Phoenix-flame/riscv-from-scratch/README.md

# Building a RISC-V CPU from Scratch (Simulation)

A step-by-step tutorial that builds a working **RV32I** single-cycle
processor in Verilog, simulated with **Icarus Verilog** and inspected with
**GTKWave**, on **Ubuntu 24.04**. Every module is delivered with a
self-checking testbench, so you always know whether a step works.

> _Developed collaboratively with Claude (Anthropic) — RTL, tests, software,
> and docs._

## What you will end up with

A processor that can execute real RISC-V machine code, including:

- Integer arithmetic / logic (`add`, `sub`, `and`, `or`, `xor`, `slt`, ...)
- Immediate instructions (`addi`, `andi`, `slli`, ...)
- Loads and stores (`lw`, `sw`)
- Branches and jumps (`beq`, `bne`, `blt`, `jal`, `jalr`)
- Upper-immediate instructions (`lui`, `auipc`)

It will run a small assembly program (computing a sum / a Fibonacci
sequence) and we will watch the registers change in the waveform viewer.

## Roadmap

| Step | Document | What we build | Status |
|---|---|---|---|
| 00 | `docs/00-overview.md` | The plan, the ISA, the architecture | written |
| 01 | `docs/01-environment-setup.md` | Install & verify the toolchain | written |
| 02 | `docs/02-verilog-crash-course.md` | Verilog refresher tied to real code | written |
| 03 | `docs/03-alu.md` | The ALU + testbench | **done & tested** |
| 04 | `docs/04-register-file.md` | The 32-register file | **done & tested** |
| 05 | `docs/05-memories.md` | Instruction & data memory | **done & tested** |
| 06 | `docs/06-immediate-and-control.md` | Immediate decode + control unit | **done & tested** |
| 07 | `docs/07-datapath.md` | Wiring the single-cycle datapath | **done & tested** |
| 08 | `docs/08-program-and-run.md` | Assemble a program & run it | **done & tested** |
| 09 | `docs/09-debugging-in-gtkwave.md` | Reading waveforms like a pro | **done & tested** |
| 10 | `docs/10-running-c.md` | Bonus: compile C and run it | **done & tested** |
| 11 | `docs/11-peripherals.md` | Bonus: UART, timer & a bus (SoC) | **done & tested** |
| 12 | `docs/12-initialized-data.md` | Bonus: string/array constants in RAM | **done & tested** |
| 13 | `docs/13-printf-without-libc.md` | Bonus: printf/snprintf via a mini-lib | **done & tested** |
| 14 | `docs/14-fpga-zynq.md` | Bonus: real UART + synthesizable top for Zynq | **done & tested** |
| 15 | `docs/15-interrupts.md` | Bonus: CSRs, traps & a timer interrupt | **done & tested** |
| 16 | `docs/16-mul-div.md` | Bonus: multiply/divide (RV32M) | **done & tested** |
| 17 | `docs/17-pipelining.md` | Bonus: a 5-stage pipelined core | **done & tested** |
| 18 | `docs/18-illegal-instruction-and-isa-faq.md` | FAQ: assembler vs hardware + illegal-instruction trap | **done & tested** |
| 19 | `docs/19-ecall-syscalls.md` | Bonus: `ecall` system calls + a syscall ABI | **done & tested** |
| 20 | `docs/20-pipelined-exceptions.md` | Bonus: precise exceptions/interrupts in the pipeline | **done & tested** |
| 21 | `docs/21-privilege-modes.md` | Bonus: machine/user privilege levels + protection | **done & tested** |
| 22 | `docs/22-mmu-virtual-memory.md` | Bonus: Sv32 MMU — virtual memory & page faults | **done & tested** |
| 23 | `docs/23-synthesizable-fpga.md` | Bonus: synthesizable BRAM SoC for Zynq-7010 (multi-cycle core) | **done & tested** |
| 24 | `docs/24-synthesizable-mmu.md` | Bonus: synthesizable Sv32 MMU (multi-cycle page-table walker, BRAM page tables) | **done & tested** |
| 25 | `docs/25-preemptive-multitasking.md` | Bonus: preemptive multitasking — timer-driven two-task scheduler | **done & tested** |
| 26 | `docs/26-atomic-extension.md` | Bonus: RV32A atomic extension (LR/SC + AMOs) for locks & synchronization | **done & tested** |
| 27 | `docs/27-freertos.md` | Bonus: running FreeRTOS (64-bit CLINT + RTOS SoC + port scaffolding) | **done & tested** |
| 28 | `docs/28-freertos-fpga.md` | Bonus: FreeRTOS on the synthesizable Zynq-7010 SoC (BRAM, real UART) | **done & tested (sim)** |
| 29 | `docs/29-debug-stub.md` | Bonus: debug stub — hardware debug module (halt/step/breakpoints) + gdb RSP server | **done & tested** |
| 30 | `docs/30-configurable-uart.md` | Bonus: configurable UART with RX path (runtime baud/data/parity/stop) on Zynq-7010 | **done & tested (sim)** |
| 31 | `docs/31-uart-interrupts.md` | Bonus: UART interrupts + receive-to-idle (machine external interrupt, IDLE-line detection) on Zynq-7010 | **done & tested (sim)** |
| 32 | `docs/32-branch-predictor.md` | Bonus: branch predictor (BTB + 2-bit saturating counters) on the pipelined core, with measured misprediction rate | **done & tested (sim)** |
| 33 | `docs/33-plic.md` | Bonus: PLIC interrupt controller — per-source priority / enable / threshold / claim-complete multiplexing several lines into one `MEIP` | **done & tested (sim)** |
| 34 | `docs/34-compressed.md` | Bonus: the C extension — 16-bit instructions, halfword-aligned PCs, word-straddling fetch; ~29% smaller code, verified against the rv32im build | **done & tested (sim)** |
| 35 | `docs/35-floating-point.md` | Bonus: the F extension — single-precision FPU (IEEE-754 round/guard/sticky, 5 rounding modes), the `f0`–`f31` float register file, `fcsr`; runs real `-march=rv32imf` gcc output, bit-exact vs host float32 (subnormals flushed) | **done & tested (sim)** |
| 36 | `docs/36-axi-master.md` | Bonus: an AXI4-Lite master to the Zynq PS — a stall-capable bus (`dmem_ready`), a 5-channel bus-to-AXI adapter, and a wait-state PS/DDR slave model; the core stalls on variable-latency accesses and reaches PS DDR + peripherals | **done & tested (sim)** |
| 37 | `docs/37-real-libc.md` | Bonus: a real C library (picolibc) — full `printf` + `malloc`/`free` via a tiny retarget (UART `putc`, heap symbols, `_exit`); byte-exact demo, and the FreeRTOS build swapped off the shims onto picolibc | **done & tested (sim)** |
| 38 | `docs/38-isolated-processes.md` | Bonus: memory-isolated processes — merge the Sv32 MMU (22/24) with the preemptive scheduler (25): a page table per task, `satp` reloaded on each context switch; two tasks share VA `0x1000` but land in different physical pages | **done & tested (sim)** |
| 39 | `docs/39-supervisor-delegation.md` | Bonus: supervisor mode + trap delegation — add S-mode (`cpu_mc_s`, `csr_s`) with `medeleg`/`mideleg`; a user `ecall`, an illegal instruction, and a software interrupt are delivered straight to an S-mode kernel, while an `ecall` from S still reaches M | **done & tested (sim)** |
| 40 | `docs/40-riscv-tests.md` | Bonus: the official **riscv-tests** suite — the reference per-instruction tests (rv32ui/um/ua/uc/uf) run against five cores through our own target environment; 272 test programs, and the two FPU bugs they found | **done & tested (sim)** |
| 41 | `docs/41-instruction-fetch-tlb.md` | Bonus: translated instruction fetch + TLBs — the PC becomes a virtual address (execute-only pages, instruction page faults), split 4-entry I/D TLBs make a hit cost zero cycles, and `sfence.vma` invalidates them; 2.36x fewer cycles than walking every access, and the whole rv32ui/um suite passes with translation on | **done & tested (sim)** |
| 42 | `docs/42-unified-pipeline.md` | Bonus: unify the cores — one 5-stage pipeline (`cpu_pipe_u`) with RV32IMA, M/U privilege, Sv32 fetch + data translation and I/D TLBs, and stall-capable ready/valid memory ports; precise page faults committed in EX, AMOs as two MEM requests, a shared walker borrowing the D-port; riscv-tests 58/58 in M and with Sv32 on in U | **done & tested (sim)** |
| 43 | `docs/43-caches.md` | Bonus: I-cache + write-back D-cache in front of a slow, burst-oriented (DDR-like) memory, on the unchanged unified pipeline; hits cost zero cycles, misses one line burst; 11× faster than no caches at latency 10 and 25× at 40 (CPI 2.0 / 2.7 vs 22.5 / 67.6), byte-exact vs the host compiler; D-cache vs a random reference model; MMU programs and riscv-tests through tiny caches | **done & tested (sim)** |
| 44 | `docs/44-smode-and-bpred-in-the-pipeline.md` | Bonus: supervisor mode (`medeleg`/`mideleg`, `sret`, `stval`, SUM/MXR, translation in S) and the BTB + 2-bit branch predictor folded into the unified pipeline; an S-mode kernel running translated serves its user's page faults (demand paging, fetch faults), the Step 39 demo runs unchanged, and the predictor reproduces Step 32's 3544 → 879 mispredictions | **done & tested (sim)** |
| 45 | `docs/45-menuconfig-openzynq.md` | Bonus: `make menuconfig` (Kconfig) generates a RISC-V project for OpenZynq / Mitra-7010 — pipeline or multi-cycle core, every feature a parameter that removes hardware, standalone or PS-attached (AXI loader + console), with a per-configuration self-test and testbench; 9 presets pass in simulation and synthesize with Yosys 0.68 | **done & tested (sim + synth)** |
| 46 | `docs/46-bitmanip.md` | Bonus: the bit-manipulation extensions Zba/Zbb/Zbc/Zbs in the unified pipeline — a combinational unit beside the ALU, strict OP/OP-IMM decode so an unconfigured extension traps, each group a parameter and a menuconfig option; the official `rv32uzb*` riscv-tests (32) pass on all four pipeline configurations (90/90) | **done & tested (sim + synth)** |
| 47 | `docs/47-vector.md` | Bonus: the RISC-V vector extension (Zve32x subset, VLEN 64/128/256) — an element-serial unit holding EX, VRF in LUT RAM, vector memory translated by the D-TLB/walker, precise mid-vector page faults with `vstart` resume, fault-only-first, `mstatus.VS`; random differential testing against a Python RVV model (thousands of programs, with and without caches), an Sv32 fault test, a menuconfig option, and a 1.3–2.4× scalar-vs-vector benchmark | **done & tested (sim + synth)** |
| 48 | `docs/48-benchmarks.md` | Bonus: benchmarks — Dhrystone and CoreMark on the unified pipeline, timed by new `cycle`/`instret` counters (Zicntr) and stall-event counters (Zihpm) whose categories add up to every cycle exactly; **1.37 DMIPS/MHz** and **2.88 CoreMark/MHz** (3.31 with `-O3` + Zb) on ideal memory, with the predictor, compiler and cache effects broken down cycle by cycle; Verilator runs the matrix in minutes, cycle-identical to Icarus | **done & tested (sim + synth)** |
| 49 | `docs/49-bootloader-device-tree.md` | Bonus: boot ROM + device tree + SBI — a `virt`-style platform (`soc_boot`: one memory for fetch and data, an ns16550a UART, the standard CLINT, a test device) whose ROM loads CRC-checked images over the serial port, checks every segment before writing a byte, fixes up the DT (probed RAM size, `bootargs`) and stays resident as an SBI v2.0 (BASE/TIME/DBCN/SRST); `make boot` rejects two bad images, then runs an S-mode program that knows the machine only from its DT, an M-mode one that reboots through `syscon-reboot`, and Step 37's picolibc demo unchanged; `time` CSR and a refetching `FENCE.I` in `cpu_pipe_u` (riscv-tests `fence_i` now passes) | **done & tested (sim)** |
| 50 | `docs/50-plic-access-faults-svade.md` | Bonus: what a kernel expects underneath it — a standard-layout PLIC with M and S contexts (the UART's interrupt reaches S-mode as SEIP), precise access faults from a PMA check of every fetch, load/store/AMO and page-table read against the memory map (causes 1/5/7 instead of reads of 0), and Svade A/D-bit page faults in the walker; `kdemo` handles all three the way Linux does, inside `make boot` | **done & tested (sim)** |
| 51 | `docs/51-boot-memory-system.md` | Bonus: memory for the boot platform — `soc_boot` with I/D caches over one memory (`line_arb`), either block RAM (the board build, `fpga_top_boot`: 144 KiB in the PL) or 64 MiB of DDR through a new AXI4 burst master; a coherent `FENCE.I` (the core waits while the D-cache is written back and the I-cache invalidated); `make boot` passes the same transcript on all three memory systems, and riscv-tests' `fence_i` passes through unified caches (`pipe_c_uni`, 91/91) | **done & tested (sim + synth)** |
| 52 | `docs/52-misaligned-traps.md` | Bonus: misaligned accesses trap — `cpu_pipe_u` raised none and did them silently wrong; now a misaligned load / store / AMO raises cause 4 / 6 and a jump to an unaligned target cause 0, with the address in `mtval`, checked before translation; the ROM delegates them to S, and `kdemo` emulates them with a kernel-style trap entry (and a misaligned Linux user program now works, with the misaligned AMO getting SIGBUS) | **done & tested (sim)** |
| 53 | `docs/53-linux.md` | Bonus: Linux from source — `make linux` fetches pinned, hash-checked Linux 6.18, busybox 1.36.1 and musl 1.2.5, builds an RV32IMA soft-float userland and a tinyconfig-based kernel (`sw/linux/*.config`), sends it to the boot ROM over the simulated UART of `soc_boot` with 64 MiB of DDR, types seven commands at its shell and checks the transcript (17 checks, clean power-off); `make linux-fast` preloads the kernel instead | **done & tested (sim)** |
| 54 | `docs/54-linux-on-the-board.md` | Bonus: the DDR path to the Mitra-7010 — `axi4_line_master` and the DDR model at 64 bits (4-beat AXI3 bursts, the shape of `S_AXI_HP0`); `fpga_top_linux`: `soc_boot` on OpenZynq's `ps7_gp0` with HP0, its 64 MiB at PS DDR `0x1000_0000`, held in reset until the PS program (DDR init, a DDR check) says *run* over GP0; `make linux-oz OZ=...` writes the OpenZynq project and simulates its top on OpenZynq's own `ps7_gp0`; `make linux-board` boots Linux on the board's exact configuration; `rvboot send` loads a board over a USB-serial adapter | **done & tested (sim); not yet placed, routed or run on a board** |
| 55 | `docs/55-u-boot.md` | Bonus: U-Boot in front of Linux — `make uboot` fetches pinned U-Boot v2024.10 and builds it for `soc_boot` (S-mode on the ROM's SBI and device tree, no C/F/D/EFI), a simulator and a board build, plus one image holding U-Boot and the kernel; `make linux-uboot` boots it: U-Boot autoboots, `booti` moves the kernel to `0x8040_0000`, Linux reaches its shell (20 checks) | **done & tested (sim)** |
| 56 | `docs/56-boot-from-flash.md` | Bonus: booting from flash with no PC — the ROM boots an RVBI image it finds in RAM at `0x8300_0000` through the same checks (a corrupt one, or a key within a second, gives the serial prompt; `make boot-mem`); the PS program doubles as the FSBL of a `BOOT.BIN`: in QSPI boot mode it programs the PL through PCAP and copies U-Boot + Linux from flash into the RISC-V's DDR; `rvboot flash` writes `BOOT.BIN` to the QSPI flash through it, CRC- and format-checked before any erase; `make linux-frommem` boots U-Boot + Linux from memory on the board configuration; `make ps-test` runs the parser and flash writer against a controller + flash model | **done & tested (sim; FSBL against a model); not yet run on a board** |

**On the board:** [`docs/mitra-board-guide.md`](docs/mitra-board-guide.md) is the step-by-step guide to running U-Boot and Linux on the Mitra-7010: hardware, builds, the OpenZynq bitstream, wiring, bring-up checks, troubleshooting, and what "flashing" can and cannot mean for this design today.

## Directory layout

```
riscv-cpu-tutorial/
├── README.md          <- this file
├── docs/              <- the tutorial, one markdown file per step
├── rtl/               <- synthesizable hardware (the CPU itself)
├── tb/                <- testbenches (simulation-only checking code)
├── sw/                <- assembly programs the CPU will run
├── tools/             <- helper tools (rvsim: run a program & dump state)
└── build/             <- compiled simulations + .vcd waveforms (generated)
```

## Quick start (after reading step 01)

```bash
# Compile and run the ALU test
iverilog -g2012 -Wall -o build/alu_tb.vvp rtl/alu.v tb/alu_tb.v
vvp build/alu_tb.vvp

# Open its waveform
gtkwave build/alu_tb.vcd
```

Start with `docs/00-overview.md`.

## Run a program & inspect the CPU (`rvsim`)

`tools/rvsim` is a small command-line front-end that loads a program onto
the CPU, runs it, and prints the final register file, PC and memory —
without hand-writing a testbench. It accepts a raw **`.bin`**, a
**`.hex`** (`$readmemh` word image), or an **`.elf`** (converted for you).

```bash
# Run a raw binary on the single-cycle core and show the registers
tools/rvsim path/to/prog.bin

# Run the peripheral demo on the SoC (real UART output + self-halt)
tools/rvsim sw/socdemo.hex --core soc --data sw/socdemo_data.hex

# Compiled ELF, trace each cycle, and dump 16 data words from address 0
tools/rvsim prog.elf --trace --cycles 200 --mem 0:16

# Same thing through make
make run BIN=path/to/prog.bin
make run BIN=sw/socdemo.hex CORE=soc DATA=sw/socdemo_data.hex
```

Sample output:

```
──────────────────────────────────────────────────────────────
RISC-V CPU state   (cpu: single-cycle core (rtl/cpu.v))
──────────────────────────────────────────────────────────────
  program : prog.bin
  cycles  : 13     halt: PC stalled (spin loop)
  pc      : 0x00000024     instr: 0x0000006f

  x0  zero 0x00000000   x8    s0 0x00000000   x16   a6 0x00000000   x24   s8 0x00000000
  x1    ra 0x00000005   x9    s1 0x00000000   x17   a7 0x00000000   x25   s9 0x00000000
  ...
```

Useful flags (`tools/rvsim --help` for all):

| Flag | Meaning |
|---|---|
| `--core {cpu,soc}` | single-cycle core (default) or full SoC with UART/timer/halt |
| `--cycles N` | max cycles before stopping (default 200000) |
| `--trace` | print `pc`/`instr` for every retired cycle |
| `--mem START:COUNT` | hex-dump `COUNT` data words from byte `START` (e.g. `0x40:8`) |
| `--data FILE` | preload data memory (auto-derived from an `.elf`) |
| `--dec` | also show registers as signed decimals |
| `--vcd` | also write a GTKWave waveform under `build/` |

The run stops on its own when the program spins (`j .`), runs off the end,
halts via the SoC's syscon device, or hits the cycle cap. Both cores have a
4 KB (1024-instruction) instruction memory, so this is aimed at the small
bare-metal programs in `sw/`.

### Interactive mode — a stepping debugger

Run `rvsim` with **no program** (or pass `-i`) and it drops into an
interactive shell instead of a one-shot dump — a little gdb-for-the-tutorial
where you step the CPU cycle by cycle and watch the registers change, with
inline disassembly, breakpoints and a full trace.

```bash
tools/rvsim                    # empty shell — then: load sw/sum.hex
tools/rvsim -i sw/sum.elf      # load a program and start stepping
make sim BIN=sw/sum.hex        # same thing through make
```

```
rvsim 6/49 ❯ step
● cycle 7/49  pc 0x0000000c  00315863  bge sp,gp,0x1c
  Δ x2 sp  0x00000002 → 0x00000003  (3)

rvsim 7/49 ❯ break 0x1c        # stop when PC reaches the store
rvsim 7/49 ❯ continue
● cycle 44/49  pc 0x0000001c  00102023  sw ra,0(zero)
  Δ x1 ra  0x00000003 → 0x00000037  (55)
```

It works by re-running the deterministic simulation to a cycle *cursor*, so
`step`, `back`, `goto` and `continue` all just move that cursor — no waveform
digging required. Type `help` for the full command list; the highlights:

| Command | What it does |
|---|---|
| `load FILE` | load a `.bin`/`.hex`/`.elf` and reset to cycle 0 |
| `step [N]` / `back [N]` | advance / rewind N cycles, showing what changed |
| `continue` | run to the next breakpoint (or the natural halt) |
| `goto CYCLE` / `reset` | jump the cursor to an absolute cycle / to 0 |
| `break PC` / `breaks` / `delete` | set / list / remove PC breakpoints |
| `regs` / `mem START:COUNT` / `trace [N]` | inspect registers / RAM / history |
| `core {cpu,soc}` / `cycles N` / `dec` | switch core / cap / decimal display |
| `vcd` | write a GTKWave waveform of the current program |

Inline disassembly and breakpoints need a `riscv64-unknown-elf-objdump` on
`PATH`; without it the shell still steps and shows the raw instruction word.

## Run the official riscv-tests suite (`rvtests`)

`tools/rvtests` runs [riscv-tests](https://github.com/riscv-software-src/riscv-tests),
the reference per-instruction suite, against the cores. It fetches the suite
into `third_party/` on first use (pinned commit, gitignored), builds each test
against the target environment in `tests/riscv-tests/env/`, and runs them all on
a compiled-once harness.

```bash
make riscv-tests                       # default core (cpu_mc)
make riscv-tests CORE=all              # every core, plus a summary matrix
make riscv-tests CORE=pipe ARGS="add sra"
tools/rvtests --trace rv32ui-add       # one test, cycle by cycle
tools/rvtests --list                   # what would run
```

```
──────────────────────────────────────────────────────────────
  riscv-tests   core: pipe  — 5-stage pipeline RV32IM + Zicsr
                built: -march=rv32im_zicsr_zifencei -mabi=ilp32
──────────────────────────────────────────────────────────────
  rv32ui-add               pass  537 cycles
  rv32ui-fence_i           gap   unexpected trap in sub-test 0
  ...
──────────────────────────────────────────────────────────────
  rv32ui 41/41   rv32um 8/8      total 49/49   ALL PASS
```

| Core | RTL | Suites | Result |
|---|---|---|---|
| `sc` | `cpu_core.v` — single-cycle RV32IMA | ui, um, ua | 59/59 |
| `mc` | `cpu_mc.v` — multi-cycle RV32IM | ui, um | 48/48 |
| `mc_c` | `cpu_mc_c.v` — multi-cycle RV32IMC | ui, um, uc | 49/49 |
| `mc_f` | `cpu_mc_f.v` — multi-cycle RV32IMF | ui, um, uf | 58/58 |
| `pipe` | `cpu_pipe_trap.v` — 5-stage pipeline | ui, um | 49/49 |
| `mc_tlb` | `cpu_mc_tlb.v` — multi-cycle RV32IM, run with Sv32 **on** (identity map, U-mode) through the I/D TLBs | ui, um | 48/48 |
| `pipe_u` | `cpu_pipe_u.v` — unified pipeline RV32IMA, M/S/U, MMU, branch predictor (body in M) | ui, um, ua, uzba, uzbb, uzbc, uzbs | 90/90 |
| `pipe_u_vm` | `cpu_pipe_u.v` — same, body in U with Sv32 **on** | ui, um, ua, uzb* | 90/90 |
| `pipe_u_uni` | `cpu_pipe_u.v` with ONE memory for fetch and data, as `soc_boot` (Step 49) — so `fence_i` passes | ui, um, ua, uzb* | 91/91 |
| `pipe_c_uni` | the same behind I/D caches over ONE slow memory (Step 51): `fence_i` needs the D-cache cleaned and the I-cache invalidated | ui, um, ua, uzb* | 91/91 |
| `pipe_c` | `cpu_pipe_u.v` behind 512 B I$/D$ on slow memory (latency 5) | ui, um, ua, uzb* | 90/90 |
| `pipe_c_vm` | same, body in U with Sv32 **on** (PTEs read through the D$) | ui, um, ua, uzb* | 90/90 |

Tests that cannot pass on this hardware (`fence_i` on the Harvard cores, `ma_data`
on the word-RAM cores, `fmadd`) are still run and reported as documented gaps rather than
skipped, so a gap that closes shows up as readily as one that opens. See
`docs/40-riscv-tests.md` for what the suite found.

## Acknowledgements

This project was developed collaboratively with **Claude**, Anthropic's AI
assistant. Claude helped design and write the RTL, the self-checking
testbenches, the bare-metal software and toolchain flow, and all of the
step-by-step tutorial documents — with each module built bottom-up and verified
in simulation along the way.

## Future directions (roadmap beyond Step 27)

A menu of where this project can go next, grouped by goal. Rough difficulty:
🟢 weekend–week · 🟡 multi-week · 🔴 multi-month.

### Onto real silicon
- ✅ **Run FreeRTOS on the Zynq-7010** — synthesizable BRAM SoC (`soc_rtos_fpga` + `fpga_top_rtos`), real UART, verified in sim (Step 28). Vivado bitstream is the remaining manual step.
- ✅ **AXI4-Lite master to the PS** — a stall-capable core (`cpu_mc_stall` waits on `dmem_ready`), a 5-channel bus-to-AXI4-Lite adapter, and a `soc_axi` that windows `0x4000_0000` out to the PS (Step 36). Verified against a wait-state AXI slave modelling PS DDR + a peripheral; reads/writes round-trip correctly through the stalls. Full AXI4 bursts (AXI-HP for DDR bandwidth) wait on a cache or DMA engine to generate them.
- 🔴 **Tape-out flow** — push RTL through OpenLane + SkyWater sky130 to a GDSII layout.

### Deeper OS
- ✅ **Memory-isolated processes** — per-task page tables with `satp` reloaded on every context switch (Step 38). Two preempted user tasks share the same virtual addresses (private page at VA `0x1000`, stack at `0x2000`) yet map to different physical pages, so neither can touch the other's memory; the MMU enforces it, the kernel just hands each task its own address space. Built on the unmodified synthesizable MMU SoC. A TLB (and the `sfence.vma` it would require) is the natural next step.
- ✅ **Supervisor mode + `medeleg`/`mideleg`** — a third privilege level (S) with per-cause trap delegation (Step 39). Two bit-masks route traps taken below machine mode: a delegated cause vectors straight to the S-mode handler at `stvec`, updates the supervisor trap CSRs, and enters S — machine mode never runs. The demo delegates a user `ecall`, an illegal instruction, and a supervisor software interrupt to an S-mode kernel, while a non-delegated `ecall` from S still reaches M. `sstatus`/`sie`/`sip` are masked views of the machine registers; built on a fresh `cpu_mc_s`/`csr_s` so the rest of the regression is untouched. Step 44 brings S-mode to the unified pipeline, where an S-mode kernel running translated serves its user's page faults (demand paging with `stval`, SUM, fetch faults) without M ever running.
- ✅ **Instruction-fetch translation + TLB** — a new core, `cpu_mc_tlb` (Step 41), translates the PC as well as data: user code runs at a virtual address, execute-only pages work, and a leaf without `X` raises an instruction page fault (cause 12). Split fully-associative I/D TLBs (`tlb.v`, 4 entries each) cache finished walks, so a hit costs no cycles, and `sfence.vma` (all entries, or by address) invalidates them. The demo shows a stale translation surviving a PTE change until the fence; against a walk-every-access build it takes 2.36x fewer cycles, and rv32ui/um pass 48/48 with every fetch and access translated. ASID-tagged entries (so a `satp` switch needs no flush) are the natural next step.
- 🔴 **Port xv6-riscv, then Linux** — xv6 is the realistic next OS. Linux needs S-mode, MMU + TLBs, atomics (Steps 39–44), a device tree, the SBI and the boot protocol (Step 49), a PLIC on SEIP, access faults and A/D-bit handling (Step 50), and megabytes of RAM behind caches with a coherent `FENCE.I` (Step 51: 64 MiB of DDR over AXI4 in simulation), and misaligned accesses that trap so the kernel can emulate them (Step 52). Linux now boots to a busybox shell in simulation: `make linux` (Step 53) builds mainline 6.18, busybox and musl from source and checks the shell. For the board, Step 54 wires that RAM to the PS's DDR through `S_AXI_HP0` and generates the OpenZynq project (`make linux-oz`); it is simulated, not yet placed, routed or run on hardware. Step 56 lets the board boot U-Boot and Linux from its QSPI flash with no PC (`BOOT.BIN`, the PS program as FSBL). Still missing: xv6, and a bring-up of Steps 54–56 on a real board.

### Make it fast (microarchitecture)
- ✅ **Branch predictor** — BTB + 2-bit saturating counters on the pipelined core (Step 32): 3544 flushes → 879 mispredictions on the demo, ~1.3x fewer cycles. Return-address stack is the natural follow-up.
- ✅ **I-cache / D-cache** — direct-mapped I-cache and write-back, write-allocate D-cache (Step 43) on the unified pipeline's ready/valid ports, in front of `mem_slow`, a DDR-like memory (first-word latency, then one word per cycle). Hits cost nothing; a miss is one line burst. On a mixed benchmark the caches give 4.9× / 11× / 25× over no caches at latency 1 / 10 / 40 (CPI 1.8 / 2.0 / 2.7 vs ideal 1.55), and the remaining cost is exactly misses × latency. Verified against a random reference model, byte-exact vs the host compiler, and with the MMU programs and riscv-tests through 256–512-byte caches. A single-port DDR arbiter, AXI4 bursts and a registered (BRAM-sized) lookup are the next steps.
- ✅ **Unify the cores** — `cpu_pipe_u` (Step 42): the 5-stage pipeline now has atomics (RV32A), user mode, and the Sv32 MMU with translated fetch and I/D TLBs, behind stall-capable ready/valid memory ports. Data translation sits in EX so page faults are precise for free; fetch faults ride down the pipe as tokens; AMOs are two MEM requests; one walker borrows the D-port. The Step 41 TLB demo runs unchanged (1339 vs 2050 cycles on `cpu_mc_tlb`), Step 38's isolated processes run with fetch translated (and fail without the `sfence.vma`), and riscv-tests pass 58/58 both in M and with Sv32 on in U. Step 44 then folds in the two that Step 42 left out: supervisor mode with delegation (Step 39) and the branch predictor (Step 32), so the fast core now has every privilege, memory-system and prediction feature in the project; the C and F extensions (Steps 34/35) and the debug module (Step 29) remain on their own cores.
- 🔴 **Superscalar / out-of-order** — Tomasulo, register renaming, reorder buffer.

### Broaden the ISA
- ✅ **C (compressed)** — RV32IMC core (`cpu_mc_c` + `rvc_expand`, Step 34): 1:1 expansion to base instructions, halfword PCs, straddling fetches resolved in one extra cycle. Same program, 424 → 302 code bytes. A fetch buffer is the natural follow-up.
- ✅ **F (single-precision floating point)** — single-precision FPU, the `f0`–`f31` float register file, and `fcsr` (Step 35): runs real `-march=rv32imf` gcc output and matches host float32 bit-for-bit across the normal range (367-point unit test + compiled-program integration test). Subnormals are flushed to zero. Double precision (D) and the fused multiply-add family are the natural follow-ups.
- ✅ **Zb (bit-manip)** — Zba/Zbb/Zbc/Zbs in the unified pipeline (Step 46): one combinational unit beside the ALU, strict OP/OP-IMM decode so a group that is configured out traps, each group a menuconfig option; the official `rv32uzb*` riscv-tests pass on all four pipeline configurations.
- ✅ **V (vector)** — Zve32x subset on the unified pipeline (Step 47): `vsetvl*`, unit/strided/indexed/fault-only-first/whole-register memory ops translated by the MMU, integer arithmetic, multiply-add, compares, masks, reductions, slides; precise mid-vector page faults resume at `vstart`; `mstatus.VS`. Element-serial — the next performance steps are lanes, word-wide unit-stride access and chaining.
- 🔴 **RV64** — widen to 64-bit; required for Linux.

### Rigorous correctness
- ✅ **riscv-tests** — the official per-instruction suite, running against five cores (Step 40). riscv-tests ships the tests but deliberately not the environment, so `tests/riscv-tests/env/` supplies ours: a Harvard link script and a `tohost` that is the SYSCON halt register, so the store reporting the result is the store that stops the machine. 272 test programs: `sc` 59/59, `mc` 48/48, `mc_c` 49/49 (whole base suite rebuilt as RVC), `mc_f` 58/58, `pipe` 49/49. It found and fixed two real FPU bugs — `fmin.s(-0.0,+0.0)` returned `+0.0`, and `fcvt.wu.s` had its invalid flag on the wrong side of the range check. Three tests are reported as documented gaps rather than skipped: `fence_i` (the instruction ROM is write-once), `ma_data` on the word-RAM cores (misaligned accesses are silently wrong), `fmadd` (no fused multiply-add). `rv32mi`/`rv32si` are the natural next step and need the machine CSR set built out first.
- 🟡 **Differential testing vs Spike** — same program on core + reference sim, compare state each step.
- 🟡 **Benchmark** — Dhrystone / CoreMark, report DMIPS/MHz and CoreMark/MHz.
- 🔴 **Formal verification** — riscv-formal + SymbiYosys.

### Multi-core / SMP
- 🔴 **Two harts** — duplicate the core with distinct `mhartid`, shared memory + arbiter, cross-core LR/SC (where `aq`/`rl` finally matter); then SMP FreeRTOS / Linux.

### Tooling & ecosystem
- ✅ **Debug stub** — hardware debug module (halt/step/4 HW breakpoints/reg+mem access) + gdb RSP server (Step 29); transport bridge to live gdb is the remaining glue.
- ✅ **Real libc** — picolibc with full `printf` and `malloc`/`free` (Step 37). The platform contract is three hooks: a UART `putc` for `stdout`, `__heap_start`/`__heap_end` for the allocator, and `_exit`. A byte-exact demo (`make libc`) checks formatting + heap + `string.h`, and the FreeRTOS build now links picolibc with the header shims and the `firmware.c` mini-printf retired (verified running through real `printf`).
- ✅ **Bootloader + device tree** — boot ROM + DT + SBI on `soc_boot` (Step 49): images arrive over a 16550 UART with header and data CRCs, every segment is range-checked before the first write, the ROM fixes up the DTB in place (probed RAM size, `/chosen/bootargs`; `dtc` re-reads the result) and enters the payload with the RISC-V boot protocol (`a0` = hart, `a1` = DTB, S-mode), leaving an SBI v2.0 behind that forwards the machine timer as STIP. Three programs run back to back over two resets; the RX FIFO never holds more than one byte. Next: block-RAM memories for the board, a PLIC wired to SEIP, and A/D-bit handling in the walker.

### Peripherals & interrupts
- ✅ **UART interrupts + receive-to-idle** — machine external interrupt (cause 11) wired to a configurable UART, with STM32-style IDLE-line detection to receive whole variable-length messages (Step 31).
- ✅ **Interrupt controller (PLIC)** — per-source priority / enable / threshold / claim-complete multiplexing several lines into one `MEIP` (Step 33). Surfaced and fixed a read-side-effect bus bug via a new `dmem_re` read strobe. Step 50 adds the standard `sifive,plic-1.0.0` layout with an S-mode context (`plic_sifive`), so a supervisor kernel takes the UART's interrupt as SEIP.
- 🟡 **Richer peripherals** — SPI/I2C masters, GPIO with edge interrupts, a PWM/timer-capture block — each behind the same MMIO + IRQ pattern.

### For fun / applications
- 🟢🟡 **Doom (bare-metal RV32)**, a tiny TCP stack (lwIP), a shell, or framebuffer graphics — proof it's a *computer*.
