Phoenix-flame/riscv-from-scratch/docs/img/menuconfig/02-project.png

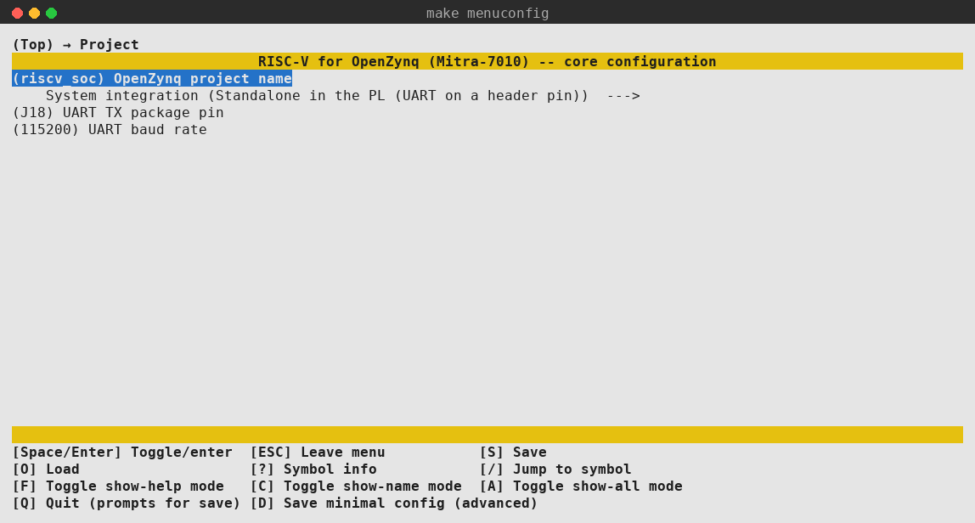
docs/img/menuconfig/02-project.png
