Phoenix-flame/riscv-from-scratch/docs/img/menuconfig/04-isa-pipe.png

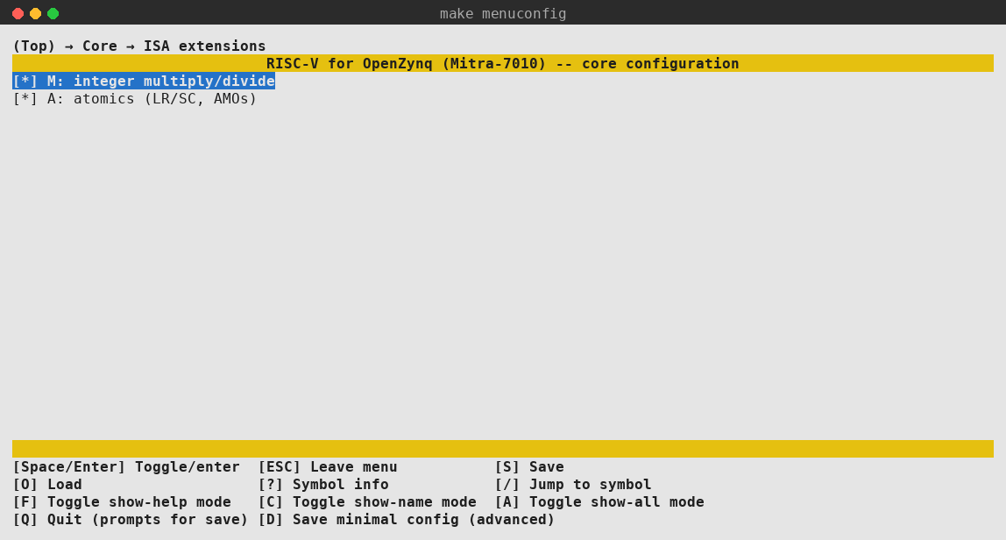
docs/img/menuconfig/04-isa-pipe.png
