Phoenix-flame/riscv-from-scratch/docs/img/menuconfig/14-edit-int.png

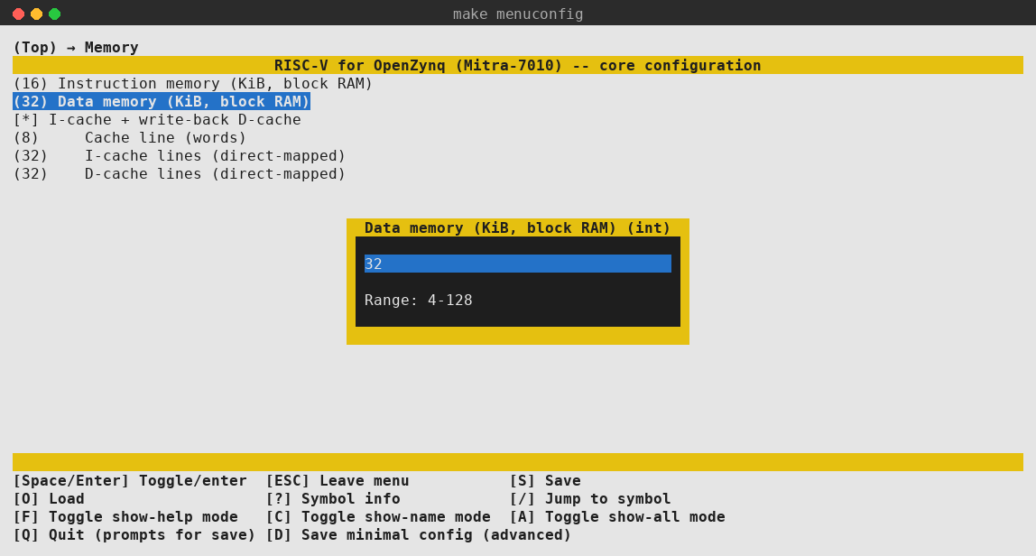
docs/img/menuconfig/14-edit-int.png
