Phoenix-flame/riscv-from-scratch/docs/img/menuconfig/16-names.png

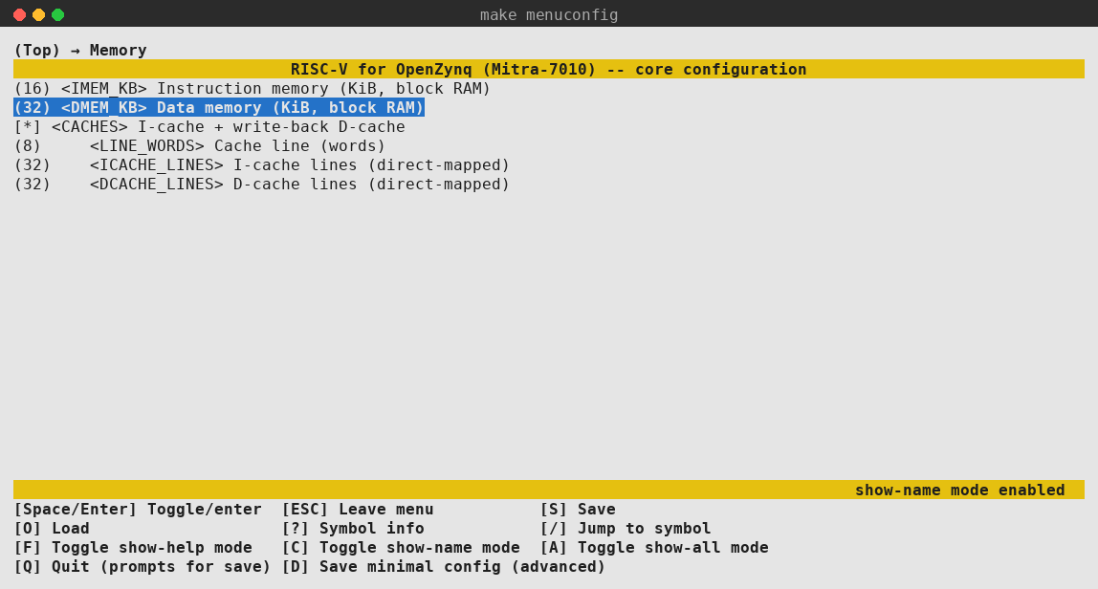
docs/img/menuconfig/16-names.png
