Phoenix-flame/riscv-from-scratch/rtl/csr.v

// =====================================================================
// csr.v  -  Machine-mode CSRs + trap controller (minimal Zicsr)
// ---------------------------------------------------------------------
// Holds the control/status registers needed for interrupts, services
// the CSR instructions (csrrw/s/c and immediate forms), and implements
// the trap entry / mret exit side effects.
//
// Supported CSRs:
//   mstatus (0x300): bit3 MIE (global enable), bit7 MPIE (previous MIE)
//   mie     (0x304): bit7 MTIE (machine timer interrupt enable)
//   mtvec   (0x305): trap handler base address (direct mode)
//   mscratch(0x340): scratch register
//   mepc    (0x341): PC saved on trap
//   mcause  (0x342): cause of the trap
//   mip     (0x344): bit7 MTIP (machine timer interrupt pending, read-only)
// =====================================================================
`default_nettype none

module csr (
    input  wire        clk,
    input  wire        rst,

    // CSR instruction port
    input  wire [11:0] csr_addr,
    input  wire [2:0]  csr_funct3,  // low 2 bits pick rw/rs/rc
    input  wire [31:0] csr_wsrc,    // rs1 value, or zero-extended zimm
    input  wire        csr_we,      // a CSR instruction is committing
    output reg  [31:0] csr_rdata,   // current value (written to rd)

    // trap interface
    input  wire [31:0] pc,          // PC of the interrupted/faulting instruction
    input  wire        timer_irq,   // level: timer says "fire"
    input  wire        ext_irq,     // level: external (e.g. UART) interrupt
    input  wire        instr_is_mret,
    input  wire        take_trap,   // computed in the core this cycle
    input  wire [31:0] trap_cause,  // mcause value to record on trap
    output wire [31:0] mtvec_out,
    output wire [31:0] mepc_out,
    output wire        irq_pending, // MIE & ((MTIE&timer) | (MEIE&ext))
    output wire [31:0] irq_cause,   // cause to record for the pending interrupt
    output wire [1:0]  cur_priv,    // current privilege: 2'b11=M, 2'b00=U
    output wire [31:0] satp_out     // address-translation control (Sv32)
);
    localparam MSTATUS=12'h300, MIE_A=12'h304, MTVEC=12'h305,
               MSCRATCH=12'h340, MEPC=12'h341, MCAUSE=12'h342, MIP=12'h344,
               SATP=12'h180;
    localparam PRIV_M=2'b11, PRIV_U=2'b00;

    reg [31:0] mstatus, mie, mtvec, mscratch, mepc, mcause, satp;
    reg [1:0]  priv;                 // current privilege level

    assign cur_priv = priv;
    assign satp_out = satp;

    wire mstatus_mie  = mstatus[3];
    wire mstatus_mpie = mstatus[7];
    wire mie_mtie     = mie[7];
    wire mie_meie     = mie[11];                // machine external interrupt enable

    wire ext_fire   = mie_meie & ext_irq;
    wire timer_fire = mie_mtie & timer_irq;
    assign irq_pending = mstatus_mie & (ext_fire | timer_fire);
    // External interrupt (cause 11) takes priority over the timer (cause 7).
    assign irq_cause   = ext_fire ? 32'h8000_000B : 32'h8000_0007;
    assign mtvec_out   = mtvec;
    assign mepc_out    = mepc;

    // Compute the next value of a CSR for a csrrw/s/c-style write.
    function [31:0] csr_next;
        input [31:0] old;
        input [31:0] src;
        input [2:0]  f3;
        begin
            case (f3[1:0])
                2'b01:   csr_next = src;          // csrrw  / csrrwi
                2'b10:   csr_next = old | src;    // csrrs  / csrrsi
                2'b11:   csr_next = old & ~src;   // csrrc  / csrrci
                default: csr_next = old;
            endcase
        end
    endfunction

    // ---- Combinational read ----
    always @(*) begin
        case (csr_addr)
            MSTATUS : csr_rdata = mstatus;
            MIE_A   : csr_rdata = mie;
            MTVEC   : csr_rdata = mtvec;
            MSCRATCH: csr_rdata = mscratch;
            MEPC    : csr_rdata = mepc;
            MCAUSE  : csr_rdata = mcause;
            SATP    : csr_rdata = satp;
            MIP     : csr_rdata = {20'b0, ext_irq, 3'b0, timer_irq, 7'b0}; // MEIP@11, MTIP@7
            default : csr_rdata = 32'd0;
        endcase
    end

    // ---- Sequential update: trap > mret > CSR write ----
    always @(posedge clk) begin
        if (rst) begin
            mstatus  <= 32'd0;
            mie      <= 32'd0;
            mtvec    <= 32'd0;
            mscratch <= 32'd0;
            mepc     <= 32'd0;
            mcause   <= 32'd0;
            satp     <= 32'd0;
            priv     <= PRIV_M;               // reset into machine mode
        end else if (take_trap) begin
            mepc        <= pc;                 // resume/faulting instruction
            mcause      <= trap_cause;         // supplied by the core
            mstatus[7]  <= mstatus[3];         // MPIE <- MIE
            mstatus[3]  <= 1'b0;               // MIE  <- 0 (disable during ISR)
            mstatus[12:11] <= priv;            // MPP  <- privilege we came from
            priv        <= PRIV_M;             // traps always enter M-mode
        end else if (instr_is_mret) begin
            mstatus[3]  <= mstatus[7];         // MIE  <- MPIE
            mstatus[7]  <= 1'b1;               // MPIE <- 1
            priv        <= mstatus[12:11];     // restore privilege from MPP
            mstatus[12:11] <= PRIV_U;          // MPP  <- least privilege (U)
        end else if (csr_we) begin
            case (csr_addr)
                MSTATUS : mstatus  <= csr_next(mstatus,  csr_wsrc, csr_funct3);
                MIE_A   : mie      <= csr_next(mie,      csr_wsrc, csr_funct3);
                MTVEC   : mtvec    <= csr_next(mtvec,    csr_wsrc, csr_funct3);
                MSCRATCH: mscratch <= csr_next(mscratch, csr_wsrc, csr_funct3);
                MEPC    : mepc     <= csr_next(mepc,     csr_wsrc, csr_funct3);
                MCAUSE  : mcause   <= csr_next(mcause,   csr_wsrc, csr_funct3);
                SATP    : satp     <= csr_next(satp,     csr_wsrc, csr_funct3);
                default : ; // mip is read-only here
            endcase
        end
    end
endmodule

`default_nettype wire
