Phoenix-flame/riscv-from-scratch/rtl/alu.v

// =====================================================================
// alu.v  -  ALU for RV32IM (base integer + multiply/divide)
// ---------------------------------------------------------------------
// Combinational. 5-bit alu_op selects the operation. The multiply and
// divide operations implement the RV32M extension, including its
// defined results for divide-by-zero and signed overflow.
//
// NOTE: multiply/divide are written combinationally (Verilog * / %) for
// clarity. On an FPGA the multiplier maps to DSP blocks; a combinational
// divider is large -- a real core uses a multi-cycle divider. Fine here
// for a teaching/simulation core.
//
// M_EXT=0 (the configurable core, Step 45) leaves the multiplier and the
// divider out entirely: the RV32M ops then read as 0, and the core decodes
// them as illegal instructions so they never get here.
// =====================================================================
`default_nettype none

module alu #(
    parameter M_EXT = 1
) (
    input  wire [31:0] a,
    input  wire [31:0] b,
    input  wire [4:0]  alu_op,
    output reg  [31:0] result,
    output wire        zero
);
    // ---- base integer ops ----
    localparam ALU_ADD =5'd0,  ALU_SUB =5'd1,  ALU_AND =5'd2,  ALU_OR  =5'd3,
               ALU_XOR =5'd4,  ALU_SLL =5'd5,  ALU_SRL =5'd6,  ALU_SRA =5'd7,
               ALU_SLT =5'd8,  ALU_SLTU=5'd9;
    // ---- RV32M ops ----
    localparam ALU_MUL   =5'd10, ALU_MULH =5'd11, ALU_MULHSU=5'd12,
               ALU_MULHU =5'd13, ALU_DIV  =5'd14, ALU_DIVU  =5'd15,
               ALU_REM   =5'd16, ALU_REMU =5'd17;

    wire [4:0] shamt = b[4:0];

    // RV32M operands: constant zero when M_EXT=0, so synthesis folds the
    // multipliers and dividers away entirely (gating only the result mux
    // would leave them built -- the tool cannot see alu_op never selects them)
    wire [31:0] ma = M_EXT ? a : 32'd0;
    wire [31:0] mb = M_EXT ? b : 32'd0;

    // 64-bit products for the high-multiply variants.
    wire signed [63:0] a_s  = $signed({{32{ma[31]}}, ma}); // a as signed64
    wire signed [63:0] b_s  = $signed({{32{mb[31]}}, mb}); // b as signed64
    wire        [63:0] a_u  = {32'b0, ma};                 // a as unsigned64
    wire        [63:0] b_u  = {32'b0, mb};                 // b as unsigned64
    wire signed [63:0] p_ss = a_s * b_s;                   // signed   x signed
    wire        [63:0] p_uu = a_u * b_u;                   // unsigned x unsigned
    wire signed [63:0] p_su = a_s * $signed(b_u);          // signed   x unsigned

    // Division with RV32M special cases.
    wire        div0   = (mb == 32'd0);
    wire        ovf    = (ma == 32'h8000_0000) && (mb == 32'hFFFF_FFFF);
    wire signed [31:0] sa = $signed(ma);
    wire signed [31:0] sb = $signed(mb);
    // Evaluate signed divide/remainder in their own signed context. If
    // mixed with unsigned operands inside a ?: below, Verilog would treat
    // the whole expression as unsigned -- so compute them here first.
    wire signed [31:0] q_s = sa / sb;
    wire signed [31:0] r_s = sa % sb;

    always @(*) begin
        if (M_EXT == 0 && alu_op >= ALU_MUL) result = 32'd0;
        else case (alu_op)
            ALU_ADD : result = a + b;
            ALU_SUB : result = a - b;
            ALU_AND : result = a & b;
            ALU_OR  : result = a | b;
            ALU_XOR : result = a ^ b;
            ALU_SLL : result = a << shamt;
            ALU_SRL : result = a >> shamt;
            ALU_SRA : result = $signed(a) >>> shamt;
            ALU_SLT : result = ($signed(a) <  $signed(b)) ? 32'd1 : 32'd0;
            ALU_SLTU: result = (a < b) ? 32'd1 : 32'd0;

            ALU_MUL   : result = p_ss[31:0];      // low 32 (same for all signs)
            ALU_MULH  : result = p_ss[63:32];
            ALU_MULHSU: result = p_su[63:32];
            ALU_MULHU : result = p_uu[63:32];

            ALU_DIV : result = div0 ? 32'hFFFF_FFFF
                              : ovf  ? 32'h8000_0000
                              : q_s;
            ALU_DIVU: result = div0 ? 32'hFFFF_FFFF : (ma / mb);
            ALU_REM : result = div0 ? a
                              : ovf  ? 32'd0
                              : r_s;
            ALU_REMU: result = div0 ? a : (ma % mb);

            default : result = 32'd0;
        endcase
    end

    assign zero = (result == 32'd0);
endmodule

`default_nettype wire
