Phoenix-flame/riscv-from-scratch/(commit log)

2026-06-01 fix: trying another message
    [soc_demo.c]
2026-06-01 update: added printf
2026-06-03 update: addedbit timer
2026-06-06 feat: debug stub, full uart core
2026-07-26 feat: interactive rvsim stepping debugger
    Turn tools/rvsim from a one-shot batch dump into an interactive REPL
    styled after the Claude CLI: rounded banner, live prompt, readline
    history + tab-completion, colored output, and gdb-like debugging.
    The simulation is deterministic and dumps full architectural state at
    any +CYCLES=N limit, so "stepping" is just re-running to a cycle cursor
    -- no Verilog changes needed. A traced run at load captures the whole
    PC/instr history (for breakpoints and the trace view) and the halt
    state; per-cursor register/memory snapshots run on demand and are cached.
    Commands: step/back/goto/continue/reset, break/breaks/delete,
    regs/mem/trace/pc/status, core/cycles/d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
2026-10-21 feat: unified pipelined core -- RV32IMA + M/U + Sv32 + TLBs (Step 42)
    cpu_pipe_u folds the features of the slower cores into the 5-stage
    pipeline: atomics (LR/SC + AMOs), user mode, Sv32 translation of fetch
    and data with I/D TLBs and sfence.vma, behind stall-capable ready/valid
    I/D ports (so caches can plug in, Step 43).
    - data translation in EX, where traps already commit: page faults are
    precise for free; fetch faults travel as NOP tokens and trap in EX
    - AMOs are two MEM requests (read, then write) under a pipeline freeze
    - shared walker (rtl/ptw.v) borrows the D-port only when MEM is idle
    - every EX side effect gated by ex_go, held EX re-latches forwarded
    operands, so freezes and h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
2026-10-21 feat: fold S-mode + branch predictor into the unified pipeline (Step 44)
    cpu_pipe_u now uses csr_s (Step 39) and branch_predictor (Step 32):
    - S-mode: sret, medeleg/mideleg delegation to stvec, CSR privilege by
    address bits [9:8], ecall causes 8/9/11, mtval/stval (faulting VA,
    instruction bits, or PC), translation in S as well as U with the S/U
    page rules plus SUM and MXR (csr_s gains SUM/MXR in its sstatus mask)
    - BPRED parameter (default 1): IF steers by BTB + 2-bit counters, EX
    audits every guess (incl. "taken" on a non-branch, possible with a
    VA-indexed BTB across address spaces), training gated by ex_go
    Tests (make pipe-u-sv): new S-mode kernel demo running translated that
    s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
2026-10-25 feat: Step 48 -- Dhrystone / CoreMark benchmarks, Zicntr + Zihpm counters
    cpu_pipe_u gains ZICNTR (default on; menuconfig ISA_ZICNTR): 64-bit
    mcycle/minstret with read-only cycle/instret aliases, fixed-event
    hpmcounter3..7 (load-use, flush, fetch-stall, memory-freeze cycles and
    mispredictions) and mcountinhibit. minstret counts at EX commit, so a
    csrr sees exactly the older instructions; bubbles are tagged with their
    cause, so instret + hpm3..6 add up to cycle exactly.
    tools/bench fetches CoreMark (pinned) and riscv-tests' Dhrystone, builds
    them against picolibc, runs them on soc_pipe_u / soc_pipe_c (Verilator
    when present, cycle-identical to Icarus) and tabulates the results:
    1.368 DMIPS/M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
2026-10-25 feat: Step 49 -- boot ROM, device tree and SBI; load and run arbitrary programs
    A virt-style boot platform (soc_boot): one memory behind both ports, an
    ns16550a-compatible UART, the standard SiFive CLINT layout, and a test
    device for power-off / fail / warm reset. Its boot ROM receives
    CRC-checked images over the UART, range-checks every segment before
    writing, fixes up the device tree in place (probed RAM size,
    /chosen/bootargs), enters the payload with the RISC-V boot protocol
    (a0 = hart, a1 = DTB, S-mode) and stays resident as an SBI v2.0
    (BASE/TIME/DBCN/SRST + legacy), forwarding the machine timer as STIP.
    cpu_pipe_u: time/timeh read a new mtime input (tied to 0 on the other
    SoCs), and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
2026-10-26 feat: Step 50 -- PLIC, precise access faults, Svade A/D bits
    What a kernel expects of the hardware underneath it, on soc_boot:
    - plic_sifive: the standard "sifive,plic-1.0.0" layout with two
    contexts (M -> MEIP, S -> SEIP); the UART is source 10. csr_s gets a
    hardware SEIP input. make plic-sifive tests it register by register.
    - cpu_pipe_u: a PMA checker (PMA_N/BASE/SIZE/ATTR) on every fetch, load,
    store/AMO and page-table read, before the access, so a hole in the map
    or a store to the ROM is a precise access fault (1/5/7) instead of a
    read of 0. The boot ROM now sizes RAM by the first faulting load.
    - ptw: SVADE -- a leaf with A clear is a page fault, a page with D clear
    enters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
2026-10-26 feat: Step 51 -- caches, block RAM and DDR for the boot platform
    soc_boot gets a real memory system, picked by MEMSYS:
    0 ideal arrays (unchanged), 1 I/D caches over block RAM (the board),
    2 the same caches over 64 MiB of DDR through a new AXI4 burst master,
    with the firmware's 16 KiB kept in on-chip RAM.
    - line_arb: the two caches' refills / write-backs onto one line port,
    routed to the ROM, on-chip RAM or the AXI master by address.
    - axi4_line_master: one 8-beat INCR burst per cache line; tested against
    tb/axi4_mem.v, a DDR model with latency, random stalls on every channel,
    SLVERR outside its window and protocol checks (make axi4-line).
    - FENCE.I with caches: the core holds it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
2026-10-27 feat: Steps 54-55 -- Linux on the Mitra-7010 board: PS DDR over HP0, U-Boot, guide
    Step 54, the DDR path to the board:
    - axi4_line_master / axi4_mem: DATA_W = 64 (4-beat size-3 AXI3 bursts,
    the shape of S_AXI_HP0; AXI3 length/alignment checks in the model)
    - soc_boot / boot_tb: AXI_DATA_W; rvboot variants ddr64 (in make boot)
    and board-ddr (board ROM, 115200, 64 MiB over the 64-bit port)
    - rtl/fpga_top_linux.v: soc_boot (MEMSYS 2) on OpenZynq's ps7_gp0 with
    HP0, RAM = PS DDR 0x1000_0000 + 64 MiB, all on the 50 MHz PL clock;
    the core stays in reset until the PS program writes run over GP0
    (0x4000_0000 reads "RVFS"); constraints/openzynq_linux.xdc (UART RX K19)
    - sw/linux/board/ps: t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
2026-10-27 Step 56: boot from flash with no PC: the ROM boots an image in RAM, the PS program as FSBL
    - sw/boot: at reset the ROM looks for an RVBI image at BOOTMEM_ADDR
    (0x8300_0000 = PS DDR 0x1300_0000); after 1 s (a key gives the serial
    prompt) it loads it through the same header CRC, range and data CRC
    checks as a serial image, with segments limited to below it. A bad
    image falls back to boot>. make boot-mem tests valid, corrupt and key.
    - sw/linux/board/ps: in QSPI boot mode the PS program is the FSBL of a
    BOOT.BIN: it finds the bitstream and the RVBI image in the partition
    table (bootbin.c), programs the PL through PCAP (pcap.c) and copies the
    image to 0x1300_0000 from the linear QS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
2026-10-27 docs/56: the board configuration's linux-frommem result (shell 12.7 s after reset at 50 MHz)
    Claude-Session: https://claude.ai/code/session_01Mh2aJXRfaUxDtDoFAYCafs
